niel0314/Adaptive_Stroke_Rehabilitation_Exoskeleton-/Gamification/Unity/obj_file/obj file/obj file.obj

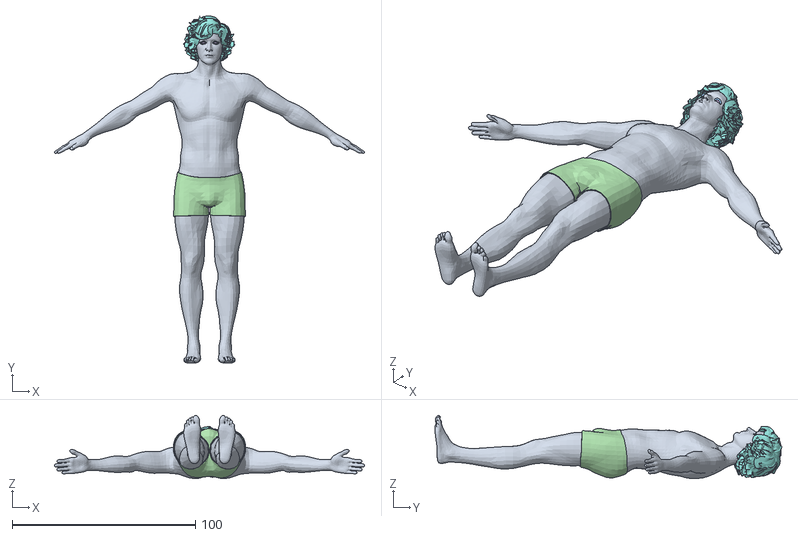
[picture p5: CAD file, 2026-05-25]
Gamification/Unity/obj_file/obj file/obj file.obj
169.2 x 189.2 x 34.5
Scalp_Male geo Geometry Group
geo Geometry Group Tongue
geo Geometry Group Body1
geo Geometry Group Boxers
geo Geometry Group Teeth
geo Geometry Group EyeOcclusion
geo Geometry Group Eye
geo Geometry Group Middle_Wavy
geo Geometry Group Body
geo Geometry Group TearLine
