niel0314/Adaptive_Stroke_Rehabilitation_Exoskeleton-/(list of files, cad)

Other CAD files:
CAD/ASSEMBLY.prt
CAD/Arm.prt
CAD/Armhouders_Bovenarm.prt
CAD/Armhouders_Onderarm.prt
CAD/Base_Plate.prt
CAD/BovenArm.prt
CAD/Encoder_AMT10.prt
CAD/HapticOndersteun.prt
CAD/MPU6050.prt
CAD/Motorplaat.prt
CAD/ODRIVE_D5312s_330KV.prt
CAD/OnderArm.prt
CAD/TacHammer Drake.prt
CAD/buskes.prt
