niel0314/Adaptive_Stroke_Rehabilitation_Exoskeleton-/(commit log)

2026-05-25 Update CAD files directory in README
2026-05-29 Update authors and correct encoder references in README
